malkusch/waterbot/(list of files, drawings)

Other design files:
pcb/prototype.fzz
