malkusch/waterbot/pcb/pot/pot.kicad_pcb

## KiCad design pcb/pot/pot.kicad_pcb (2017-07-04)

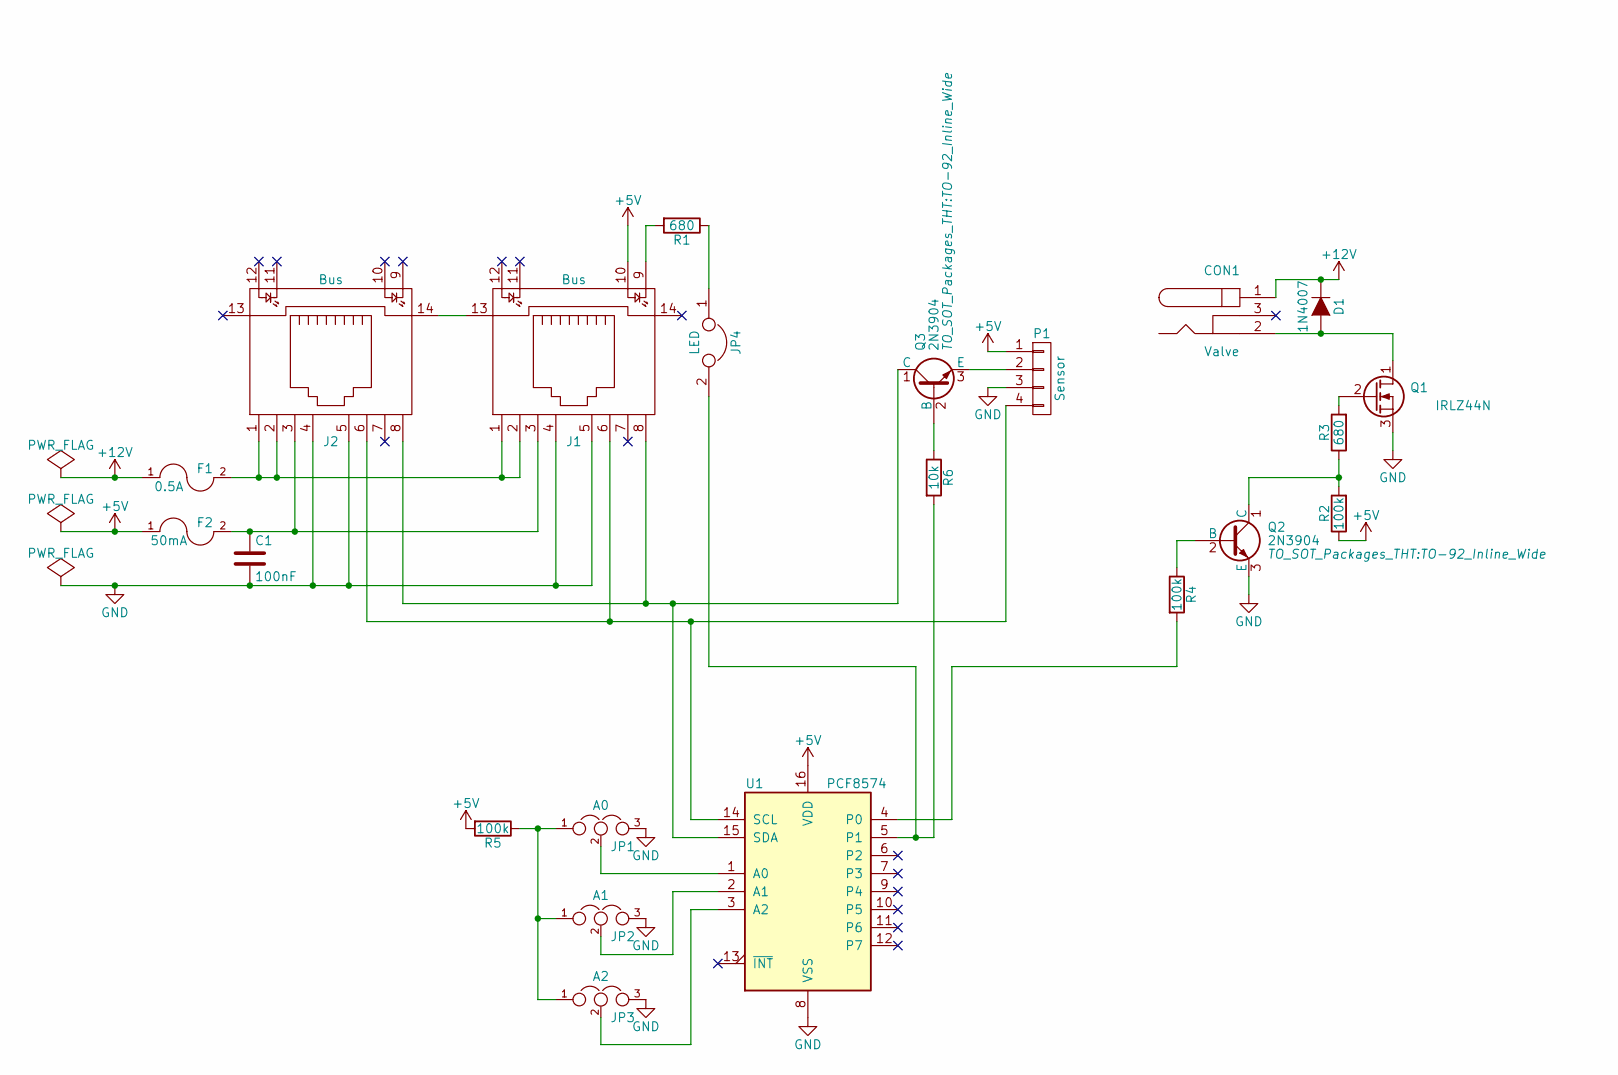
[picture p1: schematic pot.sch]

Parts:
C1: 100nF; C_Disc_D4.3mm_W1.9mm_P5.00mm
CON1: Valve; BARREL_JACK
D1: 1N4007; D_A-405_P7.62mm_Horizontal
F1: 0.5A; Fuse_TE5_Littlefuse-395Series
F2: 50mA; Fuse_TE5_Littlefuse-395Series
J1, J2: Bus; RJHSE538X
JP1: A0; Pin_Header_Straight_1x03_Pitch2.54mm
JP2: A1; Pin_Header_Straight_1x03_Pitch2.54mm
JP3: A2; Pin_Header_Straight_1x03_Pitch2.54mm
JP4: LED; Pin_Header_Straight_2x01_Pitch2.54mm
P1: Sensor; JST_XH_S04B-XH-A_04x2.50mm_Angled
Q1: IRLZ44N; TO-220_Vertical
Q2, Q3: 2N3904; TO-92_Inline_Wide
R1, R3: 680; R_Box_L13.0mm_W4.0mm_P9.00mm
R2, R4, R5: 100k; R_Box_L13.0mm_W4.0mm_P9.00mm
R6: 10k; R_Box_L13.0mm_W4.0mm_P9.00mm
U1: PCF8574; DIP-16_W7.62mm

Connections:
+5V: F2.1, J1.10, P1.1, R2.1, R5.2, U1.16 (VDD)
+12V: CON1.1, D1.1 (K), F1.1
GND: C1.2, J1.4, J1.5, J2.4, J2.5, JP1.3, JP2.3, JP3.3, P1.3, Q1.3 (S), Q2.3 (E), U1.8 (VSS)
unnamed: C1.1, F2.2, J1.3, J2.3
unnamed: CON1.2, D1.2 (A), Q1.1 (D)
unnamed: F1.2, J1.1, J1.2, J2.1, J2.2
unnamed: J1.6, J2.6, P1.4, U1.14 (SCL)
unnamed: J1.8, J2.8, Q3.1 (C), U1.15 (SDA)
unnamed: J1.9, R1.2
unnamed: J1.13, J2.14
unnamed: JP1.1, JP2.1, JP3.1, R5.1
unnamed: JP1.2, U1.1 (A0)
unnamed: JP2.2, U1.2 (A1)
unnamed: JP3.2, U1.3 (A2)
unnamed: JP4.1, R1.1
unnamed: JP4.2, R6.2, U1.5 (P1)
unnamed: P1.2, Q3.3 (E)
unnamed: Q1.2 (G), R3.2
unnamed: Q2.1 (C), R2.2, R3.1
unnamed: Q2.2 (B), R4.1
unnamed: Q3.2 (B), R6.1
unnamed: R4.2, U1.4 (P0)

Board: 2 copper layers, 22 parts (0 on the bottom side), 22 nets, no tracks yet.
