malkusch/waterbot/src/infrastructure/pcf8574/AM2321Sensor.cpp

/*
 * AM2321Sensor.cpp
 *
 *  Created on: 24.06.2017
 *      Author: malkusch
 */

#include "AM2321Sensor.h"

#include <AM2321/AM2321.h>
#include <Arduino.h>
#include <WString.h>

#include "../../model/SensorData.h"
#include "../logger/Logger.h"

using waterbot::infrastructure::pin::ON;
using waterbot::infrastructure::pin::OFF;

#define AM2321_SENSOR_RETRY_COUNT 3

namespace waterbot {
namespace infrastructure {
namespace pcf8574 {

AM2321Sensor::AM2321Sensor(DigitalOutputPin* busSwitch) :
		busSwitch(busSwitch) {

	busSwitch->write(OFF);
}

SensorData AM2321Sensor::read() {
	AM2321 am2321;
	busSwitch->write(ON);

	for (byte i = 0; i < AM2321_SENSOR_RETRY_COUNT; i++) {
		if (am2321.read()) {
			break;

		} else {
			Logger::getLogger()->warn(F("Failed reading sensor"));
			continue;
		}
	}
	busSwitch->write(OFF);

	SensorData data;
	data.moisture = am2321.humidity / 1000.0;
	data.temperature = am2321.temperature / 10.0;

	return data;
}

} /* namespace pcf8574 */
} /* namespace infrastructure */
} /* namespace waterbot */
