malkusch/waterbot/Pump.cpp

/*
 * Pump.cpp
 *
 *  Created on: 13.05.2017
 *      Author: malkusch
 */

#include "Pump.h"

#include "TimeUnits.h"

Pump::Pump(byte pin, byte pumpSeconds) :
		pin(pin), pumpSeconds(pumpSeconds) {

	pinMode(pin, OUTPUT);
	turnOff();
}

void Pump::pump() {
	turnOn();
	delay(TimeUnits::secondsToMillis(pumpSeconds));
	turnOff();
}

void Pump::turnOff() {
	digitalWrite(pin, HIGH);
}

void Pump::turnOn() {
	digitalWrite(pin, LOW);
}
