malkusch/waterbot/src/infrastructure/pcf8574/PCF8574PotRepository.h

/*
 * PCF8574PotRepository.h
 *
 *  Created on: 24.06.2017
 *      Author: malkusch
 */

#pragma once

#include <Arduino.h>

#include "../../model/PotRepository.h"
#include "../../model/DryStrategyFactory.h"
#include "../pin/DigitalOutputPin.h"

using waterbot::model::PotRepository;
using waterbot::model::Pot;
using waterbot::model::DryStrategy;
using waterbot::model::Pump;
using waterbot::model::DryStrategyFactory;
using waterbot::infrastructure::pin::DigitalOutputPin;

namespace waterbot {
namespace infrastructure {
namespace pcf8574 {

class PCF8574PotRepository: public PotRepository {
public:
	PCF8574PotRepository();
	~PCF8574PotRepository();
	void begin(DryStrategyFactory*, Pump*, const byte valvePin,
			const unsigned int valveDelayMillis, const byte sensorPin,
			const byte ledPin, const byte errorLedPin);
	virtual byte count();
	virtual Pot** findAll();

private:
	bool probeAddress(const byte address);
	byte extractId(const byte address);
	Pot** pots;
	byte size;
};

} /* namespace pcf8574 */
} /* namespace infrastructure */
} /* namespace waterbot */
