malkusch/waterbot/Logger.cpp

/*
 * SensorLogger.cpp
 *
 *  Created on: 14.05.2017
 *      Author: malkusch
 */

#include "Logger.h"

Logger::Logger(LED warnLED) :
		warnLED(warnLED) {
	Serial.begin(9600);
}

Logger* Logger::logger;

Logger* Logger::getLogger() {
	return logger;
}

void Logger::setLogger(Logger* logger) {
	Logger::logger = logger;
}

void Logger::info(int potId, SensorData data, bool pumping) {
	String message = String(data.moisture);
	message += ",";
	message += potId;
	message += ",";
	message += pumping;
	log(INFO, message);
}

void Logger::warn(const String& message) {
	warnLED.turnOn();
	log(WARN, message);
}

void Logger::log(LogLevel level, const String& message) {
	String logMessage = String(millis());
	logMessage += ",";
	switch (level) {
	case WARN:
		logMessage += "WARN";
		break;
	case INFO:
		logMessage += "INFO";
		break;
	default:
		logMessage += level;
		break;
	}
	logMessage += "," + message;
	Serial.println(logMessage);
}
