malkusch/waterbot/Pot.h

/*
 * Pot.h
 *
 *  Created on: 18.05.2017
 *      Author: malkusch
 */

#ifndef POT_H_
#define POT_H_

#include <Arduino.h>

#include "Logger.h"
#include "MoistureSensor.h"
#include "Pump.h"
#include "SensorData.h"
#include "Valve.h"

class Pot {
public:
	Pot(byte maxWaterlessDays, unsigned int coolDownSeconds,
			MoistureSensor moistureSensor, int moistureThreshold, Valve valve,
			Pump pump);
	void waterIfNeeded();

private:
	const byte id;
	const byte maxWaterlessDays;
	const unsigned int coolDownSeconds;
	MoistureSensor moistureSensor;
	static byte nextId;
	const int moistureThreshold;
	const Valve valve;
	Pump pump;
	unsigned long lastWaterTime;

	bool isHot();bool isDry(SensorData data);
	SensorData readSensors();
};

#endif /* POT_H_ */
