malkusch/waterbot/(commit log)

2017-05-17 Make it run on the Arduino
2017-05-17 Decrease probe frequency
2017-05-17 Make this project buildable in the Arduino Eclipse IDE
2017-05-17 Analyze moisture sensor data
2017-05-18 Fix int overflow
    maxPumplessDays was overflowing on the way to become milliseconds.
    [growbot.cpp]
2017-05-18 Pause before the first sensor readings
    When reading the sensor instantly, it reads a too low voltage. This
    commit ads a pause of a few seconds before the first sensor read.
    [growbot.cpp]
2017-05-19 Support multiple pots
    Each pot has its own sensors and a valve. If a pot decides it's time for
    watering, it opens its valve and starts the pump. When finished the pump
    is stoped and the valve closed.
    Pots are checked sequentially. This makes the code easier and prevents
    drawing too much current at once.
    [LED.cpp, LED.h, Logger.cpp, Logger.h, Pot.cpp, Pot.h, Pump.cpp]
2017-05-19 Refactor project to have more structure
    Ok, this commit does a few things:
    - Separate the model from infrastructure code
    - Refactor the Logger into an abstract Logger and a SerialLogger
    implementation. As soon as my Data Logging Shield arrives, I will
    implement a SDCard logger.
    - Refactor Valve into an interface and OnboardValve. I'm planing to
    support more pots than using the onboard pins directly. The same
    refactoring happend for Valve.
2017-05-20 Wait a short time for valves and the pump
    Valves and the pump don't act instantly. This commit adds a delay after
    opening and closing valves and turning off a pump. This should
    effectively avoid pumping against a completely closed system.
    Before this commit a the pump would be activated right after setting the
    valve pin to HIGH. This effectivly turns on the pump and the valve in
    the same moment, Until the valve did not physically open, the pump would
    work against a closed system. This commit adds 0,5 to all physical
    actions.
    [Pump.cpp, growbot.cpp]
2017-05-20 Fix new multi pot code
    [Logger.cpp, Logger.h, Pot.cpp, Pump.cpp, growbot.cpp]
2017-05-20 Monitor sensor health
    Sensors could be wired up wrongly or simply break. This commit checks
    that the standard error is small and also the readings are not at the
    extreme ends (e.g. unpluged sensor). Also the mean was replaced with the
    median as noise reduction. The median is more resistant against
    outliners.
2017-05-21 Format log level to string without default case
    Without a default case the compiler would issue a warning if an enum
    member was forgotten.
    [Logger.cpp]
2017-05-21 Reduce memory usage
    The pots now share a pointer to the pump. Before the pump was copied in
    each pot.
2017-05-22 Consider millis() overflow
2017-05-23 Analyze 24 average
    Temperature has a high effect on resistance. You can see a 24h
    oscilation in the data. I'd like learn if the 24h average is a better
    feature to learn about dryness.
2017-05-24 Pause between readings
    It turns out that the wires save some energy (capacitive and/or
    inductive). This pause should help to remove that saved energy to
    Ground. Otherwise it would affect the sensor readings. I.e. the first
    reading of a bulk would be very different as subsequent, as it doesn't
    have the saved energy in the wires.
2017-05-24 Debug sensors during pause
    Arduino resets itself during pausing. I assume there's a voltage spike
    in those long wires.
    [waterbot.cpp]
2017-05-24 Pause between switching polarisation
    An instant polarisation change might have inductive and capacitive
    effects on the first readings after the switch. This commit divides
    reading from a sensor in two batches which have a pause of no voltage in
    between.
2017-05-25 Invert moisture value
    After the last refactoring of OnboardMoistureSensor, I accidentially
    inverted the values of the moisture sensor.
2017-05-25 Test millis() overflow
2017-05-26 Align X axises
2017-05-27 Integrate temperature sensor
2017-05-30 Use RTC
    This commit adds support to the DS1307 RTC. The logger would now use the
    unix timestamp as first value. When the RTC is not running (e.g. battery
    was empty), it will set the compilation time.
2017-05-30 Log to SD card
    Logging to the SD shield requires 4 pins (SPI). That's why one pot was
    removed with this commit. Also all other pots got a different wiring.
    More pots will be supported with mulitplexing or a BUS (1-wire or I²C).
2017-05-31 Support removing and inserting of SD card
2017-05-31 Implement DC moisture sensor
2017-06-01 Increase moisture read delay
    After some tests on the breadboard it turns out, that the sensor needs
    at least 8 seconds to deliver a stable voltage.
2017-06-02 Add pin abstraction
    I don't add this additional abstraction for fun. It's necessary to
    support everything on multiplexed pins as well.
2017-06-16 Analyze more sensor data
2017-06-16 Design water control breadboard
    [prototype.fzz]
2017-06-17 Fix inverted pump behaviour
    [Pump.cpp]
2017-06-17 Use timer strategy for watering
    The current sensors depend too much on temperature and I don't have a
    temperature sensor yet. For a first working prototype I will simply
    water the pots once a day.
    [waterbot.cpp, waterbot.h]
2017-06-25 Implement Pots on the I²C bus
    [prototype.fzz]
2017-06-25 Add LED for each pot
    [prototype.fzz]
2017-06-26 Decrease power consumption
    [prototype.fzz]
2017-06-28 Fix broken millis()
    When entering a power save mode, millis() stops working. This commit
    changes the behaviour into just entering idle mode.
    [waterbot.cpp, waterbot.h]
2017-06-28 Support AM2321 sensor
    The AM2321 humidity and temperature sensor uses one I²C address. I have
    to multiplex between other sensors. The original idea, was simply
    controlling the power of the sensor with the IO expander. While testing
    that, it doesn't work reliably.
    First, althout the sensor uses way less
    than 4mA, I could't source the voltage from the expander, so I had to
    sink it. When controlling the power sink, it turns out that the sensor
    worked very unreliable. I.e. I had to wait many seconds before getting a
    successful read, and also not every read was successful. Also, there was
    some signal on the data bus, so I assume it would sink some power
    through the I²C wires.
    This commit adds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
    [pot.kicad_pcb, pot.sch, prototype.fzz]
2017-06-30 Support more pots
    This commit refactors the code to safe some SRAM. This allows 15 pots
    with the SerialLogger. When using the SDLogger, significantly less pots
    are supported. If you need to support more than 15 pots, you can
    implement a NullLogger. This will free up some memory for more pots.
    Note, with the PCF8574 there are only up to 16 pots on I²C supported.
    However you could add even more pots directly on the Arduino's I/O pin
    or even more with a Multiplexer like CD74HC4067. But at that point you
    certainly will run out of memory. Consider using a further complete
    system (i.e. an additional Arduino with pump).
2017-06-30 Add pot PCB
    [pot.kicad_pcb, pot.sch]
2017-07-04 Retry on failed AM2321 read
    [AM2321Sensor.cpp]
2017-07-04 Place pot LED on sensor pin
    The sensor pin is most of the times LOW, so it could sink the LED's
    current. When reading the sensor the LED will turn off. This will also
    help as indicator to see if the pin was successfully restored to LOW
    after reading the sensor. Currently the PCF8574 lib doesn't pass any
    error codes further. If an LED is off, it's a good indicator for an
    invalid state.
    [pot.kicad_pcb, pot.sch, prototype.fzz]
2017-07-04 Fix bus switch
    [pot.kicad_pcb, pot.sch, prototype.fzz]
2017-07-04 Log sensor uid
    This should help to confirm that for each pot a different sensor is
    used.
2017-07-04 Retry on pin PCF8574 I²C failures
    [AM2321Sensor.cpp, PCF8574DigitalOutputPin.cpp, PCF8574SinkPin.cpp]
2017-07-20 Fix bus switch
    During prototyping I destroyed a bunch of N7000. It seems they're very
    sensitive and need a pull down on the Gate. During prototyping I
    connected the gate directly to GND or VDD. I don't know if the act of
    unplugging the gate manually did destroy them or connecting them
    directly. Adding a pull down resistor fixed that issue. However it might
    not be necessary when using the port extender. I need to investigate
    further to understand why they broke so easily.
    [pot.sch, prototype.fzz]
2017-07-21 Decrease watering frequency
    Three times a day is too much. One was too less. I try three now.
    [waterbot.h]
2017-08-02 Revert "Log sensor uid"
    It turns out, that reading the id on an AM2322 doesn't work. Moreover it
    prevents reading any other data from the sensor.
    This reverts commit be4ef404995391e0da384abbd37b7a7dfca84cf0.
    [AM2321Sensor.cpp]
2017-08-02 Detect sensor automatically
    When using the PCF8574 port extender as bus switch, any switched I²C
    sensor (currently AM2321, AM2322 and BME280) will be used automatically.
2017-08-05 Fix wrong humidity in BME280
    [BME280Sensor.cpp]
2017-08-05 Show detected and setup pots (again)
    This commit adds the pot LED back again. It turns out, it is really
    helpful to see which pots are detected and setup successfully.
2017-08-05 Fix bus switch (firmware only)
    In order to support same sensors on multiple pots, the I²C bus needs to
    be switched on and off on each pot. That's because the sensors share all
    the same address. It turns out to work best with a multiplexer, but the
    PCB is not yet updated (also I will make some tests with transistors,
    which are smaller and cheaper). This commit doesn't contain any PCB
    change, but only a firmware change. A Wire.endTransmission() was
    necessary after switching the bus on. This is now abstracted away into
    the class BusSwitch.
    [BusSwitch.cpp, BusSwitch.h, PCF8574PotRepository.cpp, PCF8574Sensor.cpp, PCF8574Sensor.h]
2017-08-05 Add HTU21D sensor
    That's an extremly cheap humidity and temperature sensor. A break out
    board costs less than 2$. Note: it's a 3.3V device and therefore needs a
    logic level shifter for the I²C bus.
2018-06-09 Use a MOSFET as bus switch
    [pot.sch]
2018-06-09 Wait longer to recover from failed sensor
    [AM2321Sensor.cpp]
2018-06-09 Pull up bus switch per default
    The IO expander is up per default and up means that the bus is switched
    off (hence a P-channel transistor).
    [pot.sch]
2018-06-11 Signal where sensors were found
    This commit does a few things. First, it assumes each bus switch is off
    per default. That makes the logic in software simpler. Then the signal
    LED on each expander is used to signal where a sensor was detected. This
    helps to see if the system detected everything successfully.
2018-06-28 Ignore errors from sensors
    [AM2321Sensor.cpp, PCF8574Sensor.cpp, Pot.cpp]
2018-06-28 Generalize probed and switched sensors
    It turns out that I can't use a humidity sensor to just measure moisture
    in the soil. Humidity in soil is always 100%. However in a recent
    experiment I measure humidity near soil. Currently it is additionally
    30% more humid than air. If this turns out to be feasible, I will need a
    reference sensor for the current air humidity. The reference sensor
    would be globally accessible on the I2C bus and can be switched directly
    from the Arduino. This commit generalizes the previous code to have a
    switched sensor controlled by the Arduino.
2018-06-28 Decrease memory consumption
    Using pointers when there is only one existing reference does increase
    the memory footprint. This commit does refactor such usages to values.
2018-06-28 Blink LEDs on pots
    During the pause, the LEDs of a pot do blink. This helps to signal that
    the firmware is still running. Also this commit adds the concept of an
    LED to the Pot object. I might in a follow up commit use that to signal
    that something was wrong with a specific pot (e.g. a sensor reading
    failed).
    [LED.cpp, LED.h, PCF8574PotRepository.cpp, Pot.cpp]
2018-06-29 Signal which pots have issues
    [LED.cpp, PCF8574PotRepository.cpp, PCF8574PotRepository.h, Pot.cpp, Pot.h, waterbot.cpp, waterbot.h]
